Hauke12345/Drone/media/AeroFrame35_speedrun_linkedin_portrait.gif

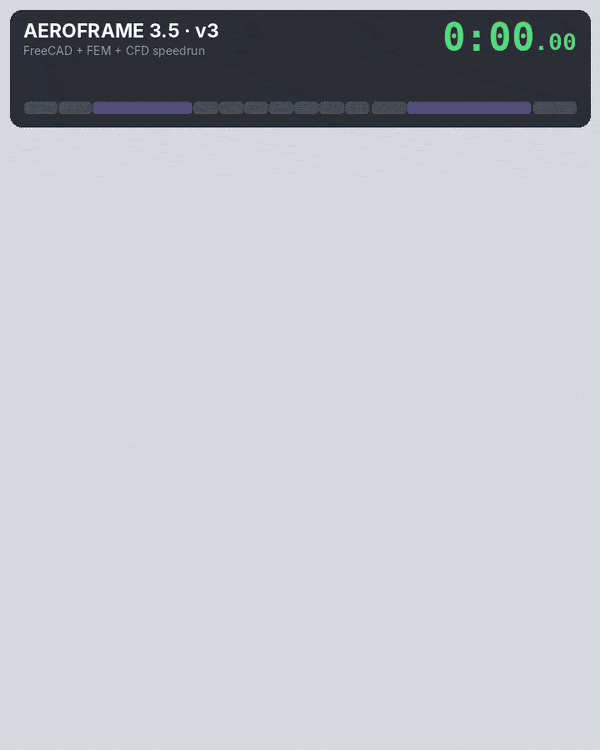
media/AeroFrame35_speedrun_linkedin_portrait.gif
