Hauke12345/Drone/media/v3_a.png

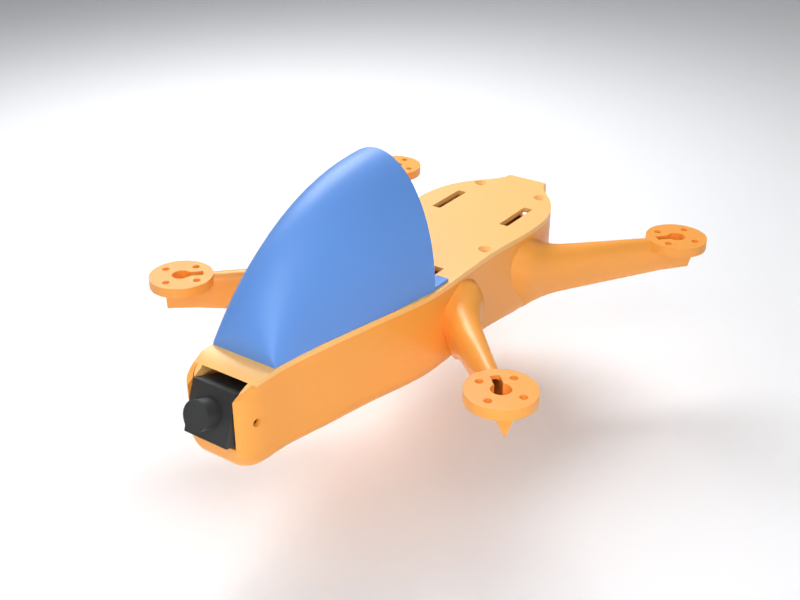
media/v3_a.png
