Hauke12345/Drone/media/v3_b.png

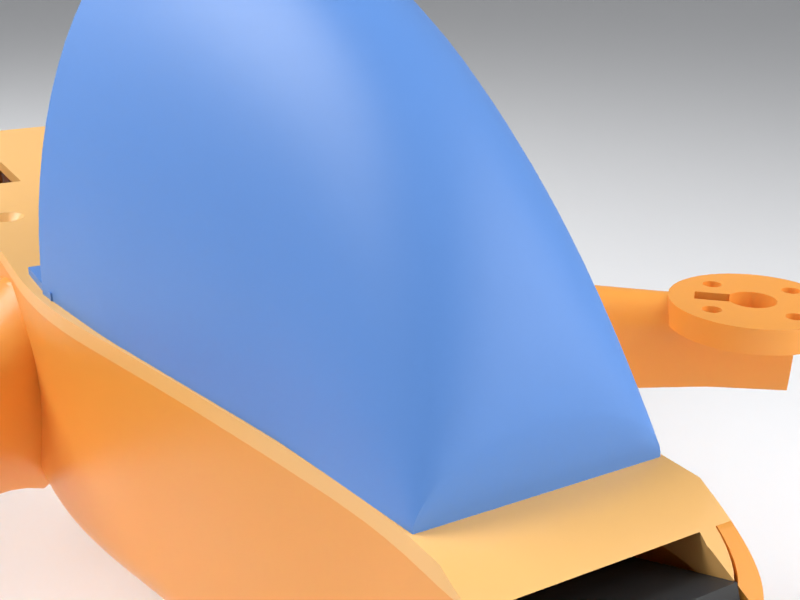
media/v3_b.png
