Hauke12345/Drone/v2/camera_view_40deg.png

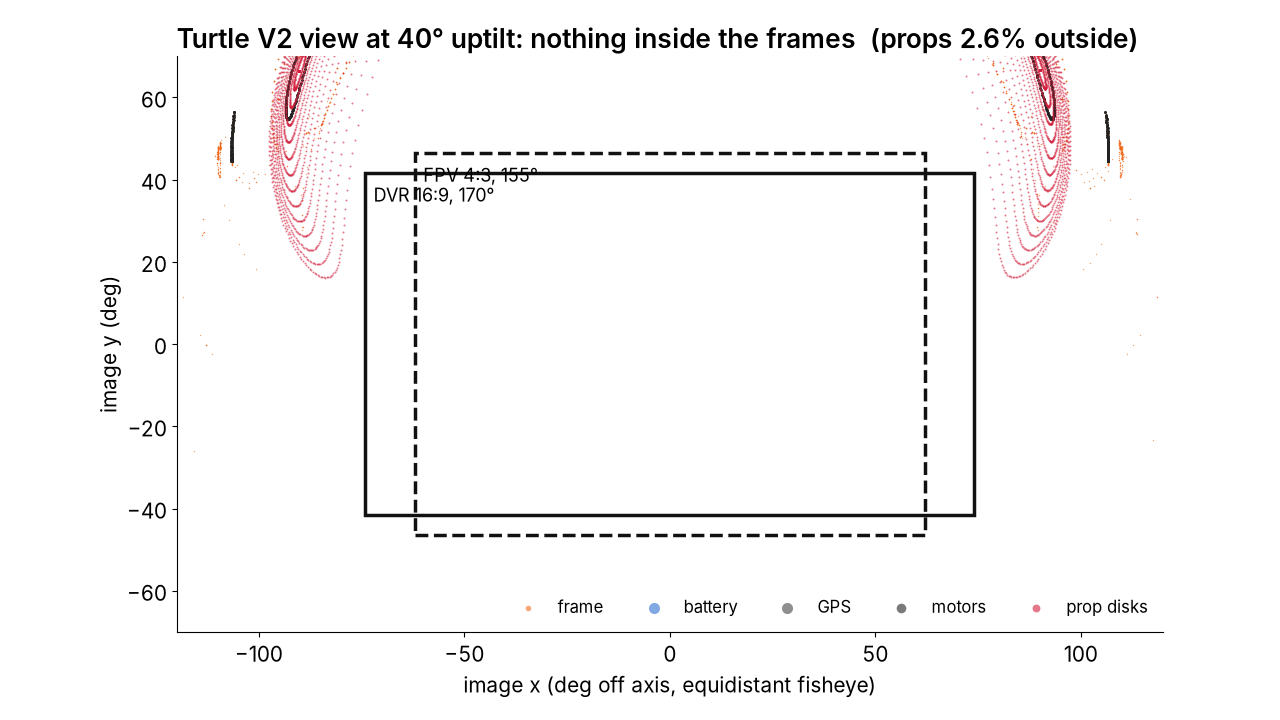
v2/camera_view_40deg.png
