Hauke12345/Drone/cad/AeroFrame35.step

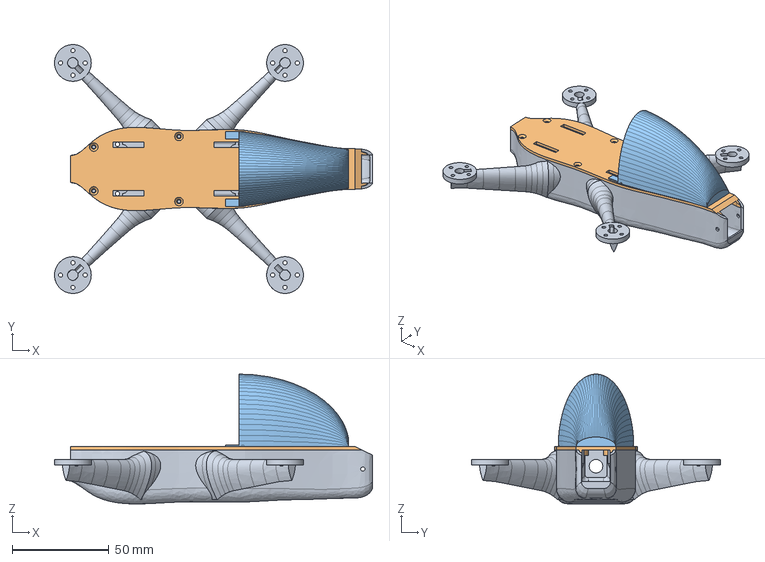
[picture p6: CAD file, 2026-10-24]
cad/AeroFrame35.step
164.3 x 128.6 x 67.1 mm
