Hauke12345/Drone/v2/AeroFrame35_lid.stl

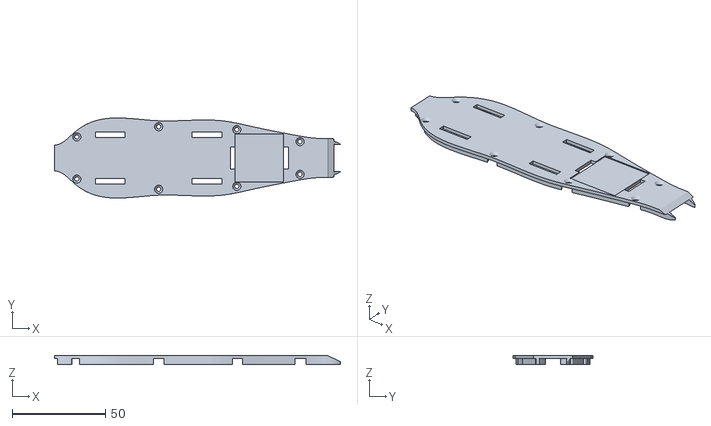
[picture p7: CAD file, 2026-10-24]
v2/AeroFrame35_lid.stl
153.8 x 43.0 x 4.60
