Hauke12345/Drone/cad/AeroFrame35_chassis.stl

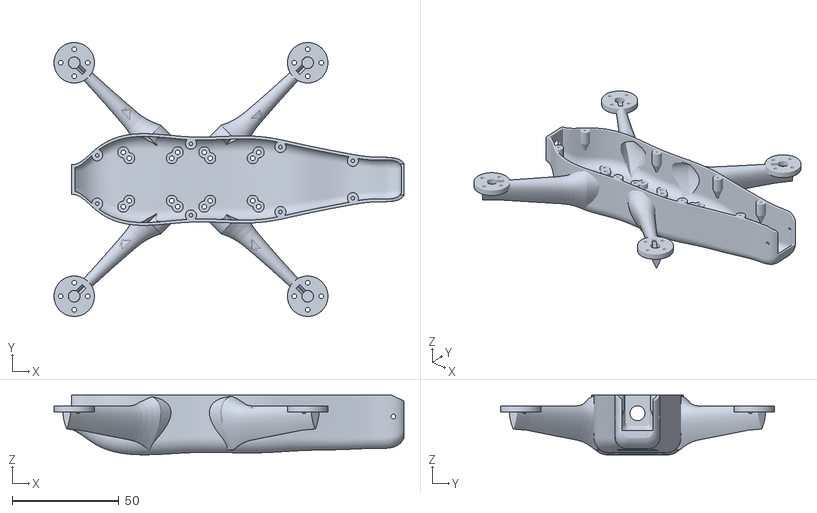
[picture p8: CAD file, 2026-10-24]
cad/AeroFrame35_chassis.stl
164.3 x 128.6 x 28.0
