Hauke12345/Drone/cad/AeroFrame35_hood.stl

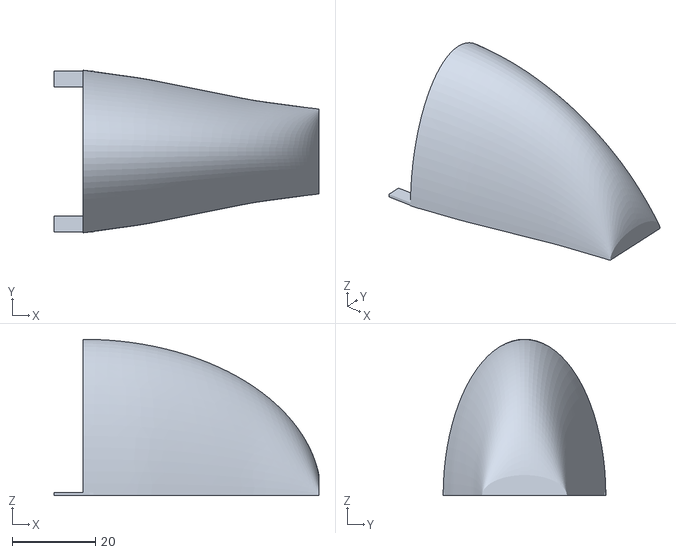
[picture p9: CAD file, 2026-10-24]
cad/AeroFrame35_hood.stl
63.5 x 39.0 x 37.5
