Hauke12345/Drone/v2/AeroFrame35.step

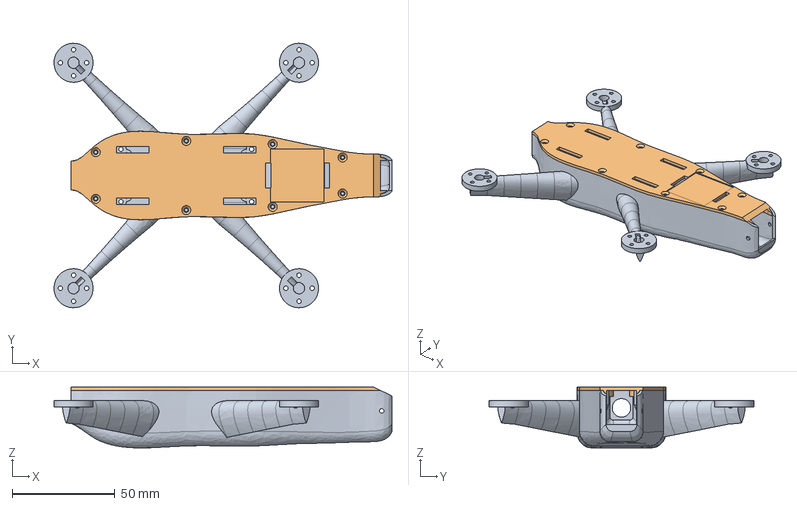
[picture p10: CAD file, 2026-10-24]
v2/AeroFrame35.step
164.3 x 128.6 x 29.6 mm
