Hauke12345/Drone/cad/reference_parts.step

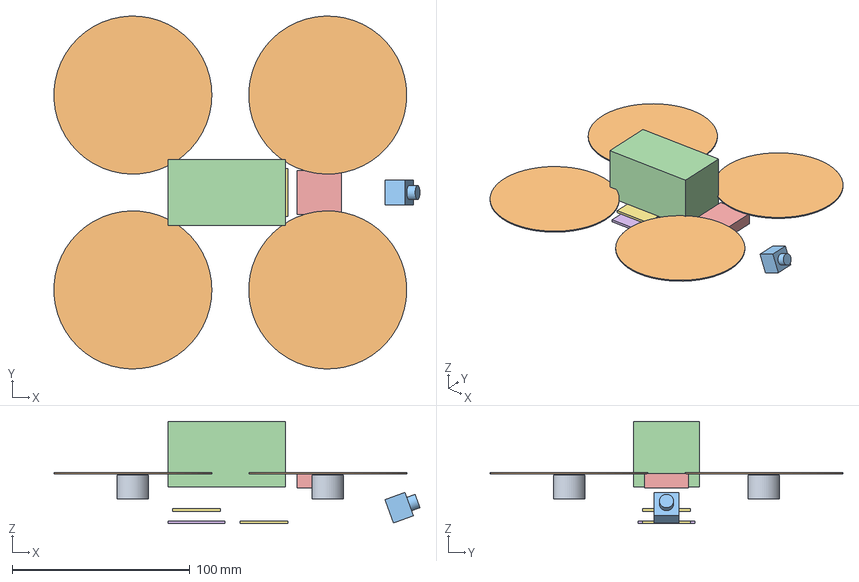
[picture p11: CAD file, 2026-10-24]
cad/reference_parts.step
205.9 x 198.5 x 57.6 mm
