Hauke12345/Drone/(list of files, cad)

Other CAD files:
v2/AeroFrame35_chassis.stl
cad/AeroFrame35_lid.stl
cad/AeroFrame35.FCStd
