Hauke12345/Drone/media/preview_assembly.png

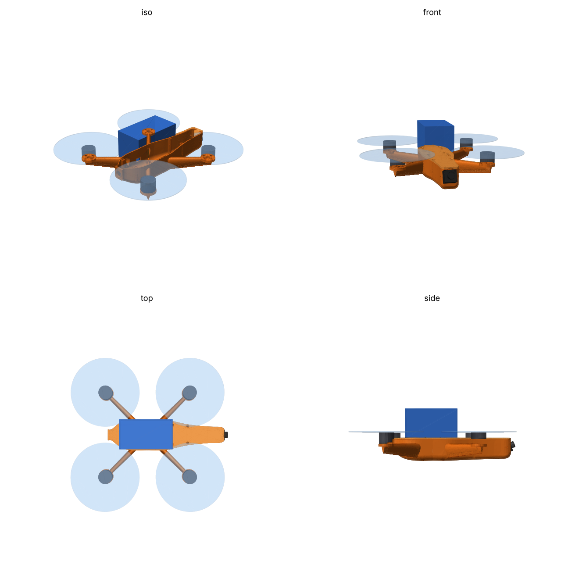
media/preview_assembly.png
