Hauke12345/Drone/results/cfd_v2_v3.png

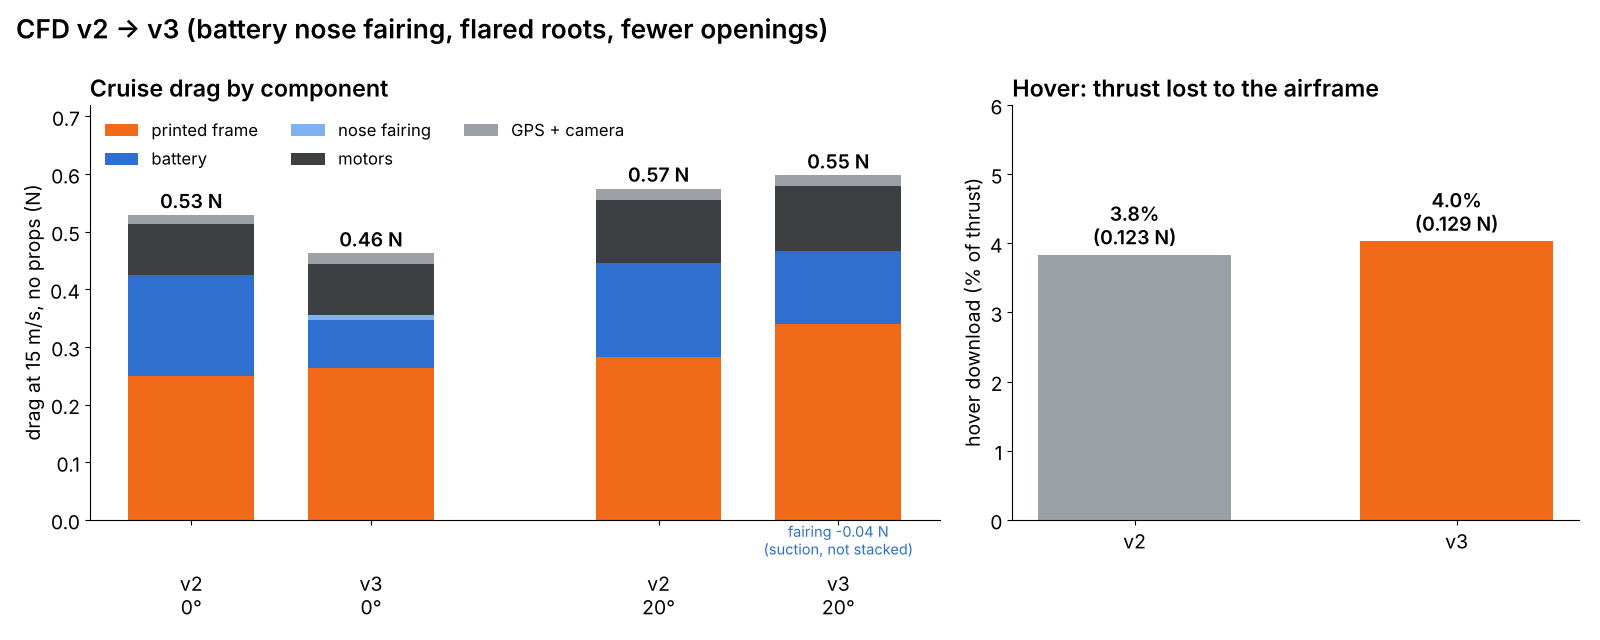
results/cfd_v2_v3.png
