Hauke12345/Drone/results/fem_modes_v3.png

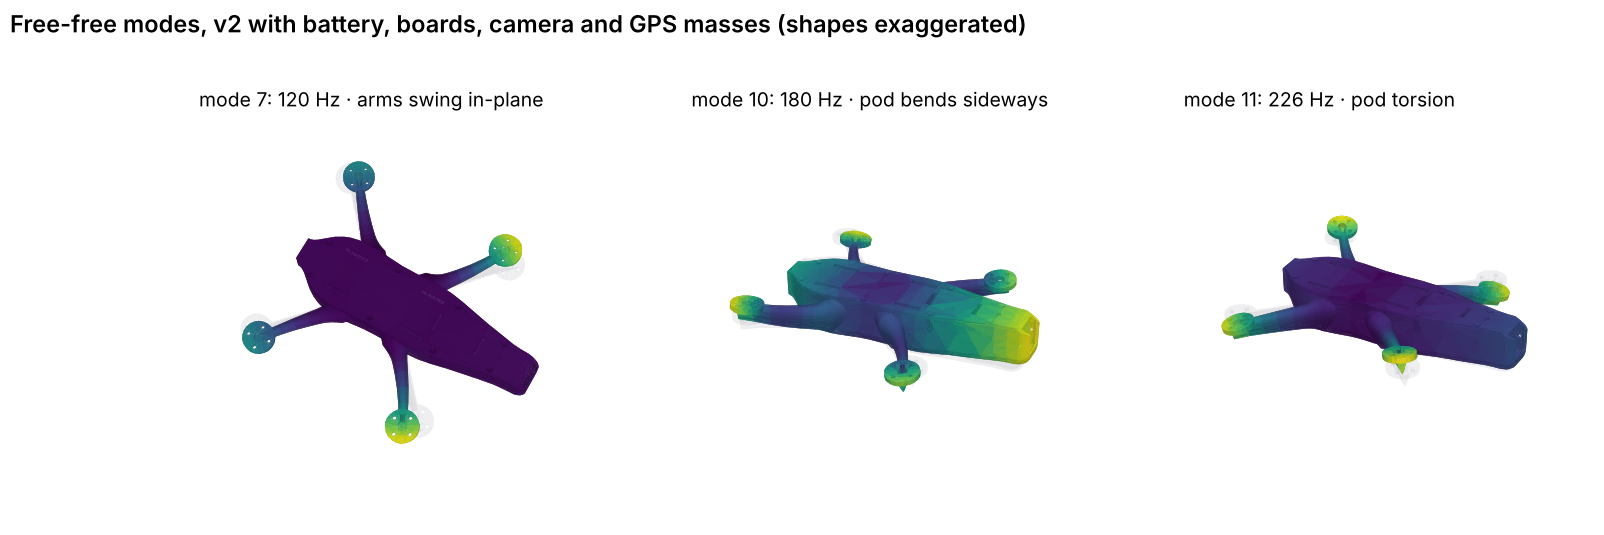
results/fem_modes_v3.png
