Hauke12345/Drone/results/fem_static_cases_v3.png

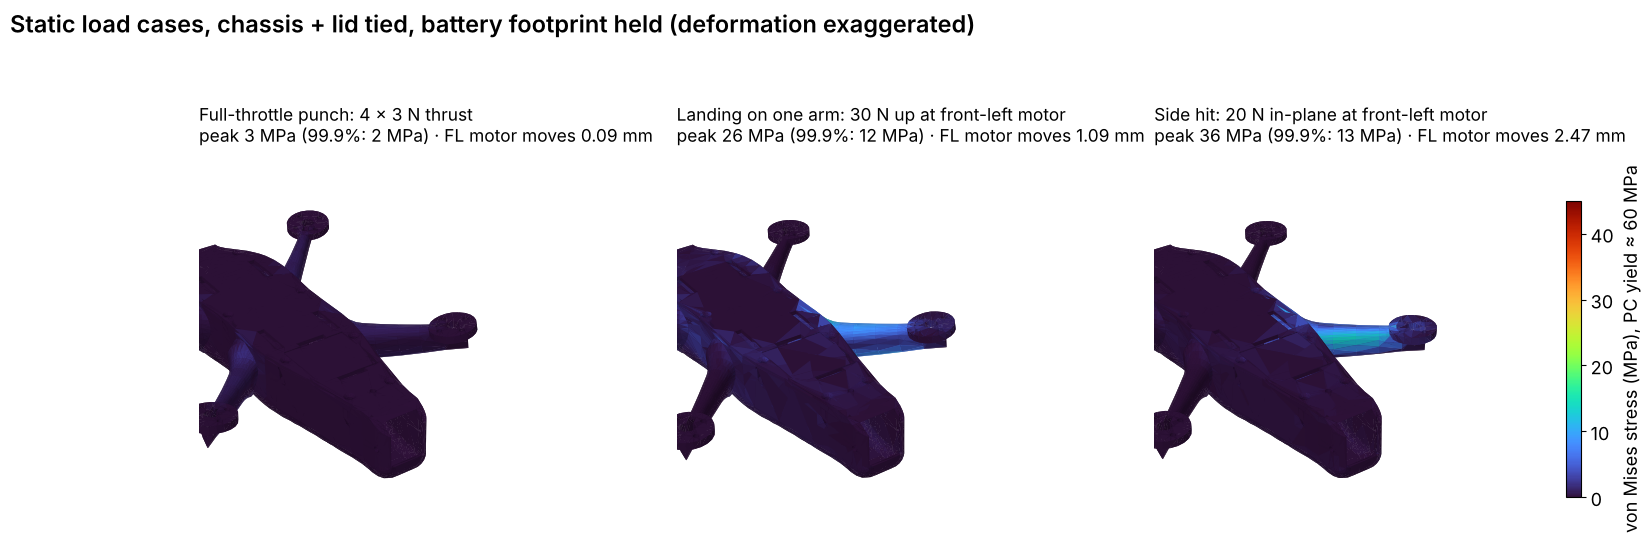
results/fem_static_cases_v3.png
