Hauke12345/Drone/results/fem_v2_v3.png

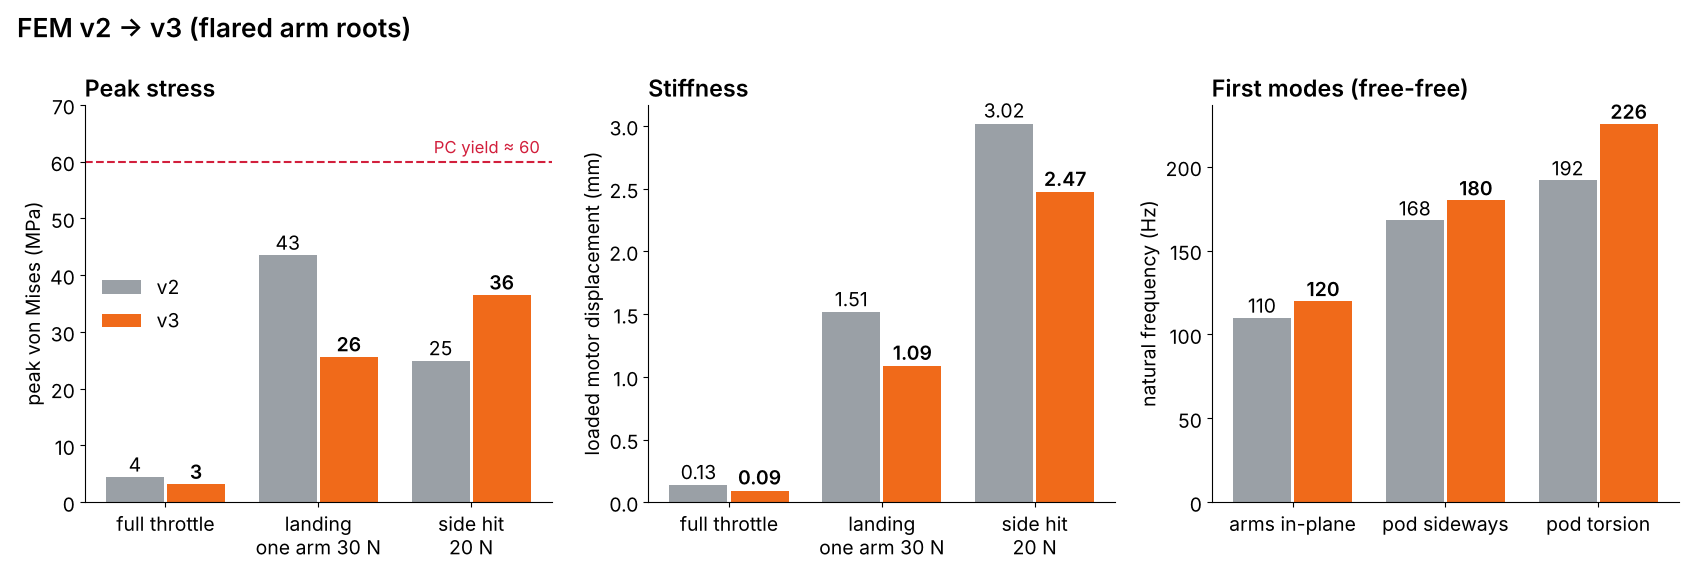
results/fem_v2_v3.png
