Hauke12345/Drone/results/v3_cruise_00_sliceY.png

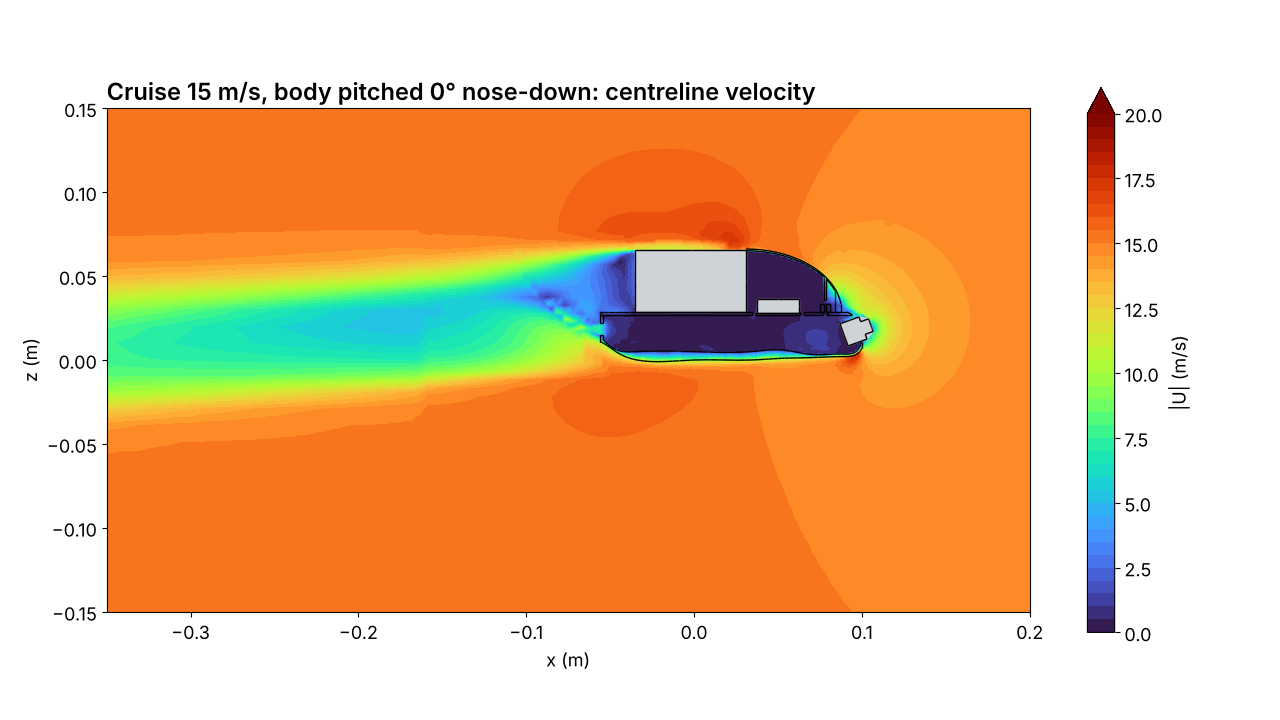
results/v3_cruise_00_sliceY.png
