Hauke12345/Drone/results/v3_cruise_20_sliceY.png

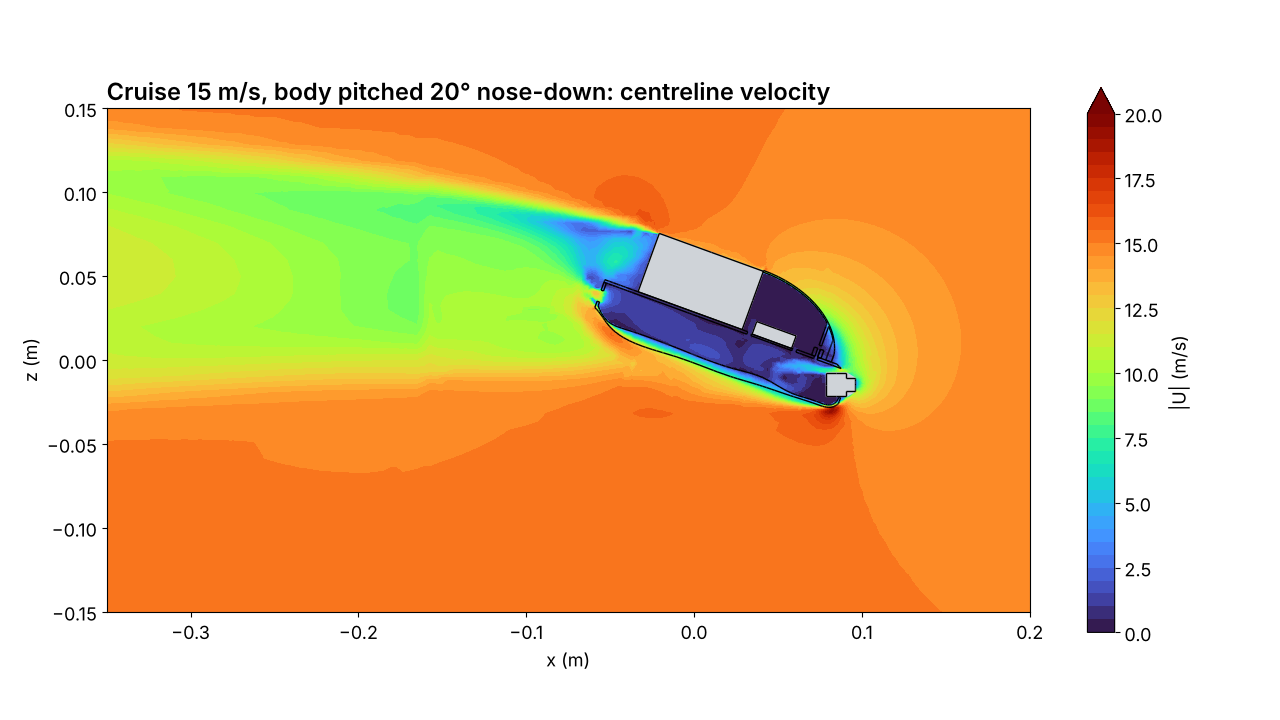
results/v3_cruise_20_sliceY.png
