Hauke12345/Drone/results/v3_hover_frame_diag.png

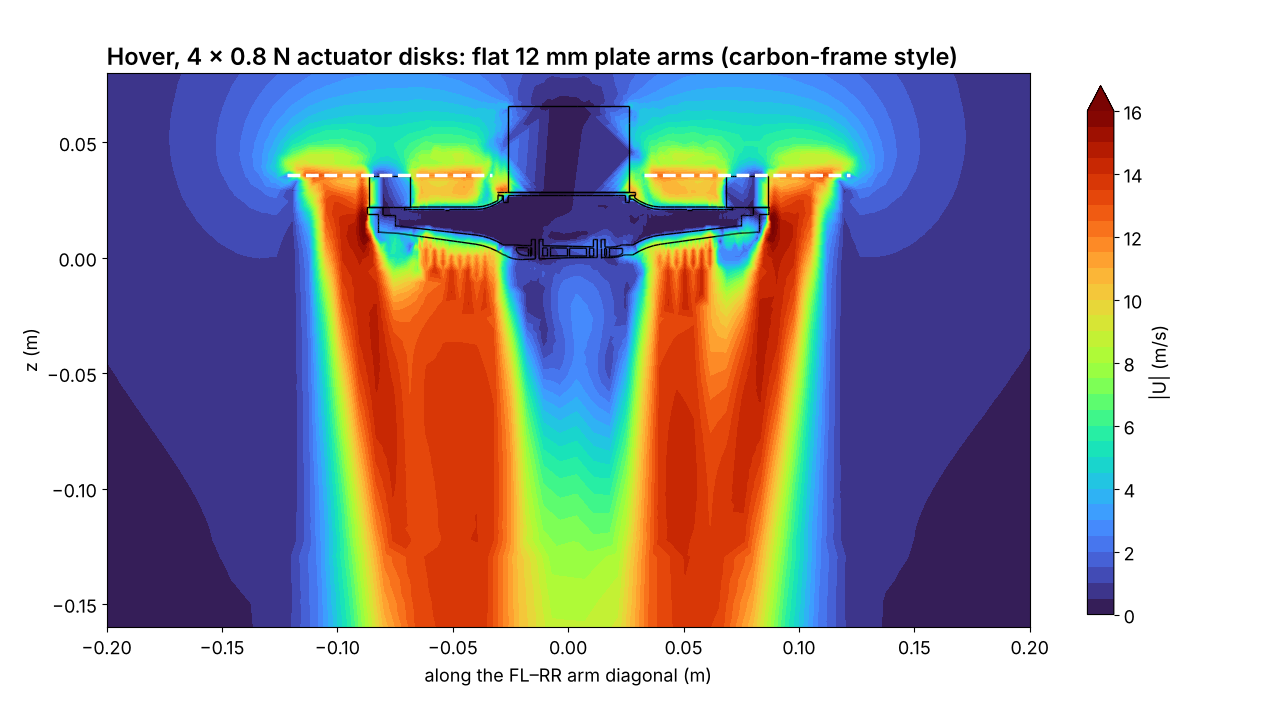
results/v3_hover_frame_diag.png
